nomatin/Servo-Hub/assets/servo_manager-3d.png

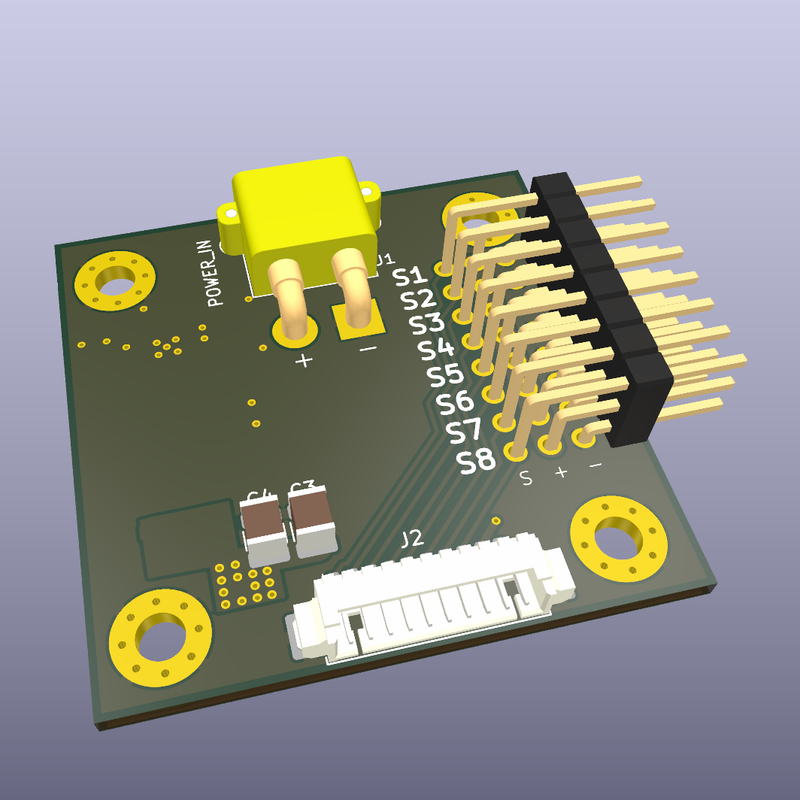
assets/servo_manager-3d.png
