nomatin/Servo-Hub/manufacturing/bom/servo_manager-bom.csv

Refs | Value | Footprint | Qty | DNP | Manufacturer | MPN | Rated Voltage | Dielectric | Datasheet
C1 | 22uF | servo_manager:CP_EIA-3528-21_Kemet-B | 1 |  | KYOCERA AVX | TCJB226M025R0100 | 25 V | Tantalum polymer | ~
C2 | 0.1uF | Capacitor_SMD:C_0805_2012Metric | 1 |  | KYOCERA AVX | 08055C104KAT2A | 50 V | X7R | ~
C3,C4 | 47uF | Capacitor_SMD:C_1210_3225Metric | 2 |  | KYOCERA AVX | 12103D476MAT2A | 25 V | X5R | ~
C5 | 10uF | Capacitor_SMD:C_0805_2012Metric | 1 |  | KYOCERA AVX | KGM21AR51E106KU | 25 V | X5R | ~
C6 | 4.7uF | Capacitor_SMD:C_0805_2012Metric | 1 |  | KYOCERA AVX | 08055D475KAT2A | 50 V | X5R | ~
C7 | 39pF | Capacitor_SMD:C_0805_2012Metric | 1 |  | KYOCERA AVX | 08055A390JAT4A | 50 V | C0G | ~
C8 | 3900pF | Capacitor_SMD:C_0805_2012Metric | 1 |  | KYOCERA AVX | 08055A392FAT2A | 50 V | C0G | ~
C9 | 0.022uf | Capacitor_SMD:C_0805_2012Metric | 1 |  | KYOCERA AVX | 08055C223MAT2A | 50 V | X7R | ~
IC1 | TPS54821RHLR | TPS54622RHLR | 1 |  | Texas Instruments | TPS54821RHLR |  |  | http://www.ti.com/lit/gpn/tps54821
J1 | POWER_IN | servo_manager:AMASS_XT30PW-M_1x02_P2.50mm_Horizontal | 1 |  | AMASS | XT30PW-M |  |  | ~
J2 | Conn_01x10_Socket | servo_manager:Molex_PicoBlade_53261-1071_1x10-1MP_P1.25mm_Horizontal | 1 |  | Molex | 0532611071 |  |  | ~
J5 | Servo_out | servo:Servo_03x08 | 1 |  | Samtec | TSW-108-08-L-T-RA |  |  | ~
L1 | 3.3 uH | servo_manager:L_Chilisin_BMRG00131360 | 1 |  | Vishay | IHLP5050EZER3R3M01 |  |  | ~
R2 | 100k | Resistor_SMD:R_0805_2012Metric | 1 |  | Yageo | RC0805FR-07100KL |  |  | ~
R3 | 10k | Resistor_SMD:R_0805_2012Metric | 1 |  | Yageo | RC0805FR-0710KL |  |  | ~
R4 | 1.37k | Resistor_SMD:R_0805_2012Metric | 1 |  | Yageo | RC0805FR-071K37L |  |  | ~
R5 | 35.7k | Resistor_SMD:R_0805_2012Metric | 1 |  | Yageo | RC0805FR-0735K7L |  |  | ~
R6 | 8.06k | Resistor_SMD:R_0805_2012Metric | 1 |  | Yageo | RC0805FR-078K06L |  |  | ~
R7 | 4.64k | Resistor_SMD:R_0805_2012Metric | 1 |  | Yageo | RC0805FR-074K64L |  |  | ~
