nomatin/Servo-Hub/board/release/servo_manager-schematic.pdf

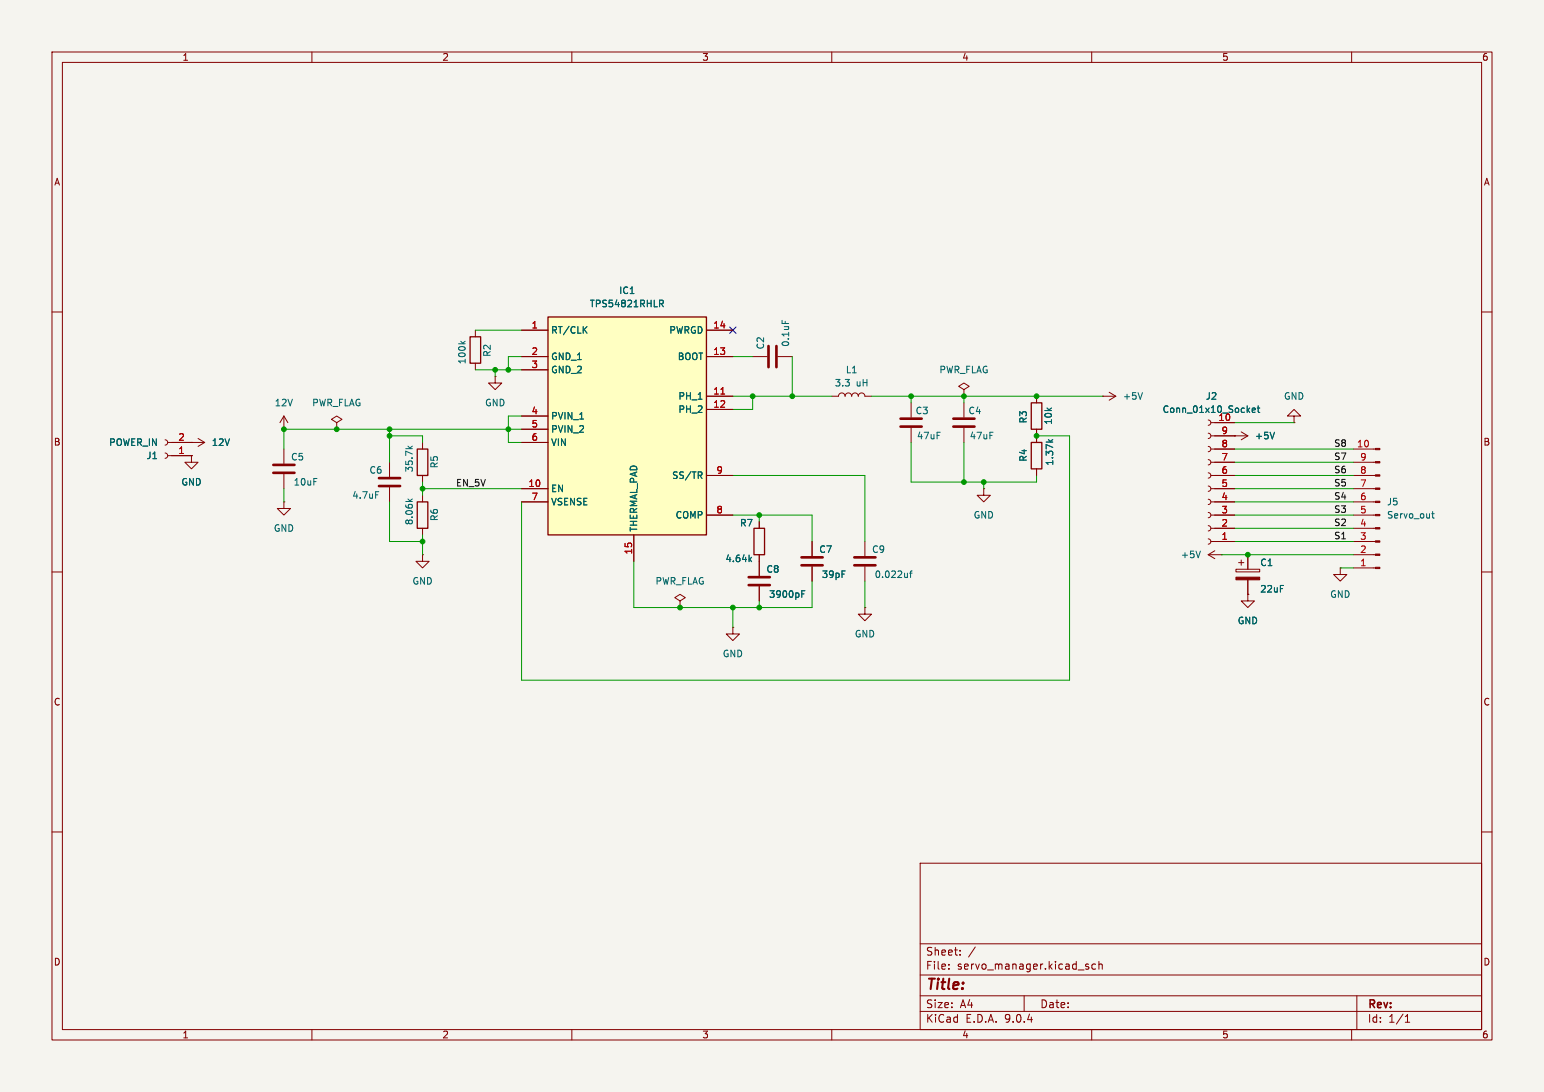
[picture p5: page 1]

Id: 1/1 Title: File: servo_manager.kicad_sch Sheet: /
