nomatin/Servo-Hub/board/servo_manager.kicad_pcb

## KiCad design board/servo_manager.kicad_pcb (2026-11-11)

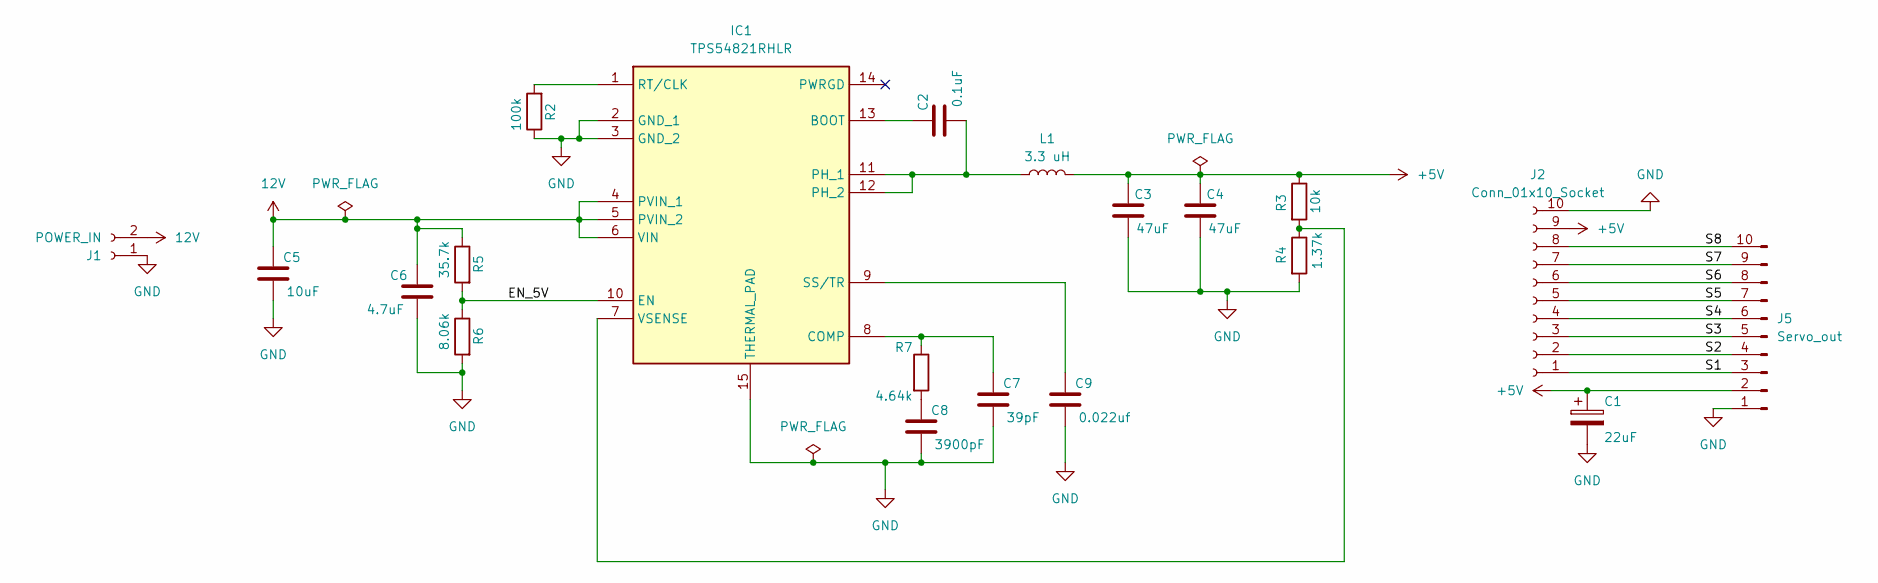
[picture p6: schematic servo_manager.kicad_sch]

Parts:
C1: 22uF; CP_EIA-3528-21_Kemet-B; Manufacturer_Part_Number TCJB226M025R0100
C2: 0.1uF; C_0805_2012Metric; Manufacturer_Part_Number 08055C104KAT2A
C3, C4: 47uF; C_1210_3225Metric; Manufacturer_Part_Number 12103D476MAT2A
C5: 10uF; C_0805_2012Metric; Manufacturer_Part_Number KGM21AR51E106KU
C6: 4.7uF; C_0805_2012Metric; Manufacturer_Part_Number 08055D475KAT2A
C7: 39pF; C_0805_2012Metric; Manufacturer_Part_Number 08055A390JAT4A
C8: 3900pF; C_0805_2012Metric; Manufacturer_Part_Number 08055A392FAT2A
C9: 0.022uf; C_0805_2012Metric; Manufacturer_Part_Number 08055C223MAT2A
IC1: TPS54821RHLR; TPS54622RHLR; Manufacturer_Part_Number TPS54821RHLR; Mouser Part Number 595-TPS54821RHLR
J1: POWER_IN; AMASS_XT30PW-M_1x02_P2.50mm_Horizontal; Manufacturer_Part_Number XT30PW-M
J2: Conn_01x10_Socket; Molex_PicoBlade_53261-1071_1x10-1MP_P1.25mm_Horizontal; Manufacturer_Part_Number 0532611071
J5: Servo_out; Servo_03x08; Manufacturer_Part_Number TSW-108-08-L-T-RA
L1: 3.3 uH; L_Chilisin_BMRG00131360; Manufacturer_Part_Number IHLP5050EZER3R3M01
R2: 100k; R_0805_2012Metric; Manufacturer_Part_Number RC0805FR-07100KL
R3: 10k; R_0805_2012Metric; Manufacturer_Part_Number RC0805FR-0710KL
R4: 1.37k; R_0805_2012Metric; Manufacturer_Part_Number RC0805FR-071K37L
R5: 35.7k; R_0805_2012Metric; Manufacturer_Part_Number RC0805FR-0735K7L
R6: 8.06k; R_0805_2012Metric; Manufacturer_Part_Number RC0805FR-078K06L
R7: 4.64k; R_0805_2012Metric; Manufacturer_Part_Number RC0805FR-074K64L

Connections:
12V: C5.1, C6.1, IC1.4 (PVIN_1), IC1.5 (PVIN_2), IC1.6 (VIN), J1.2, R5.1
+5V: C1.1, C3.1, C4.1, J2.9, J5.2, L1.2, R3.1
/EN_5V: IC1.10 (EN), R5.2, R6.1
/S1: J2.1, J5.3
/S2: J2.2, J5.4
/S3: J2.3, J5.5
/S4: J2.4, J5.6
/S5: J2.5, J5.7
/S6: J2.6, J5.8
/S7: J2.7, J5.9
/S8: J2.8, J5.10
GND: C1.2, C3.2, C4.2, C5.2, C6.2, C7.2, C8.2, C9.2, IC1.2 (GND_1), IC1.3 (GND_2), IC1.15 (THERMAL_PAD), J1.1, J2.10, J2.MP, J5.1, R2.1, R4.2, R6.2
unnamed: C8.1, R7.2
unnamed: C2.1, IC1.13 (BOOT)
unnamed: C7.1, IC1.8 (COMP), R7.1
unnamed: C2.2, IC1.11 (PH_1), IC1.12 (PH_2), L1.1
unnamed: IC1.1 (RT/CLK), R2.2
unnamed: C9.1, IC1.9 (SS/TR)
unnamed: IC1.7 (VSENSE), R3.2, R4.1

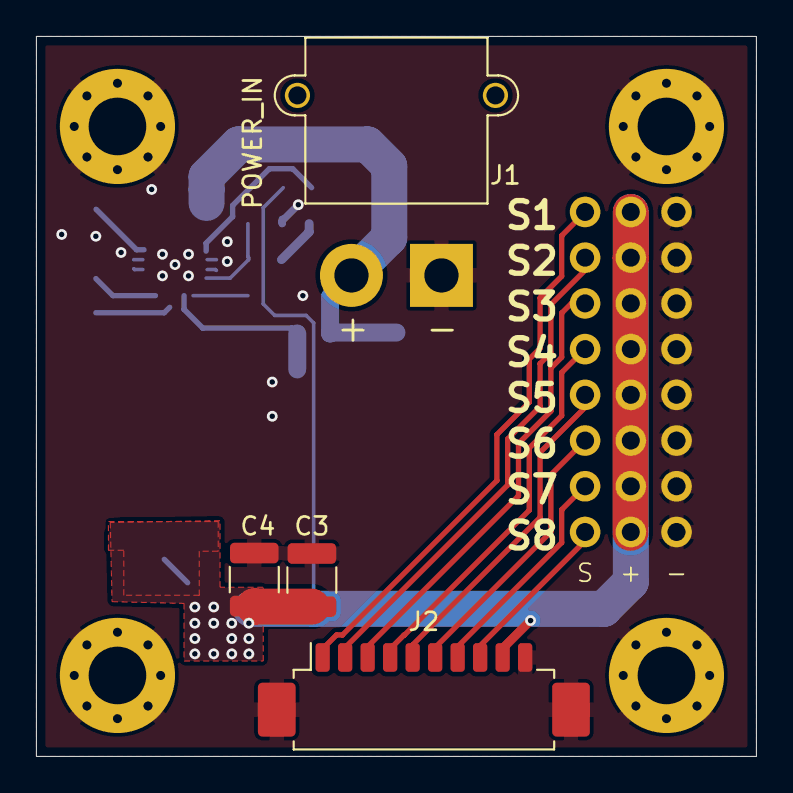
[picture p7: board servo_manager.kicad_pcb from above]

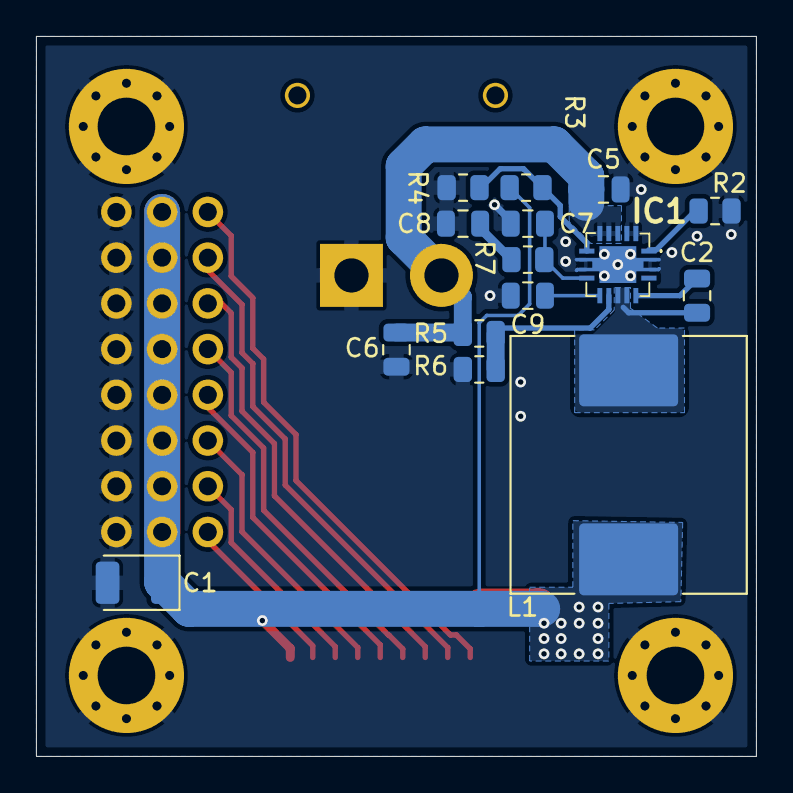
[picture p8: board servo_manager.kicad_pcb from below]

Board: 2 copper layers, 40.0 x 40.0 mm, 20 parts (15 on the bottom side), 19 nets.
