nomatin/Servo-Hub/(commit log)

2024-11-12 Первый коммит
2026-11-11 Publish Servo Hub KiCad project
    [servo_manager-bom.csv, servo_manager.kicad_pcb, servo_manager.kicad_sch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]
2026-11-11 Resize 3D board preview to 800 pixels
2026-11-11 Add README headings for board images
